jimeharrisjr/ESP8266_MotionDetection/Hardware/circuit.png

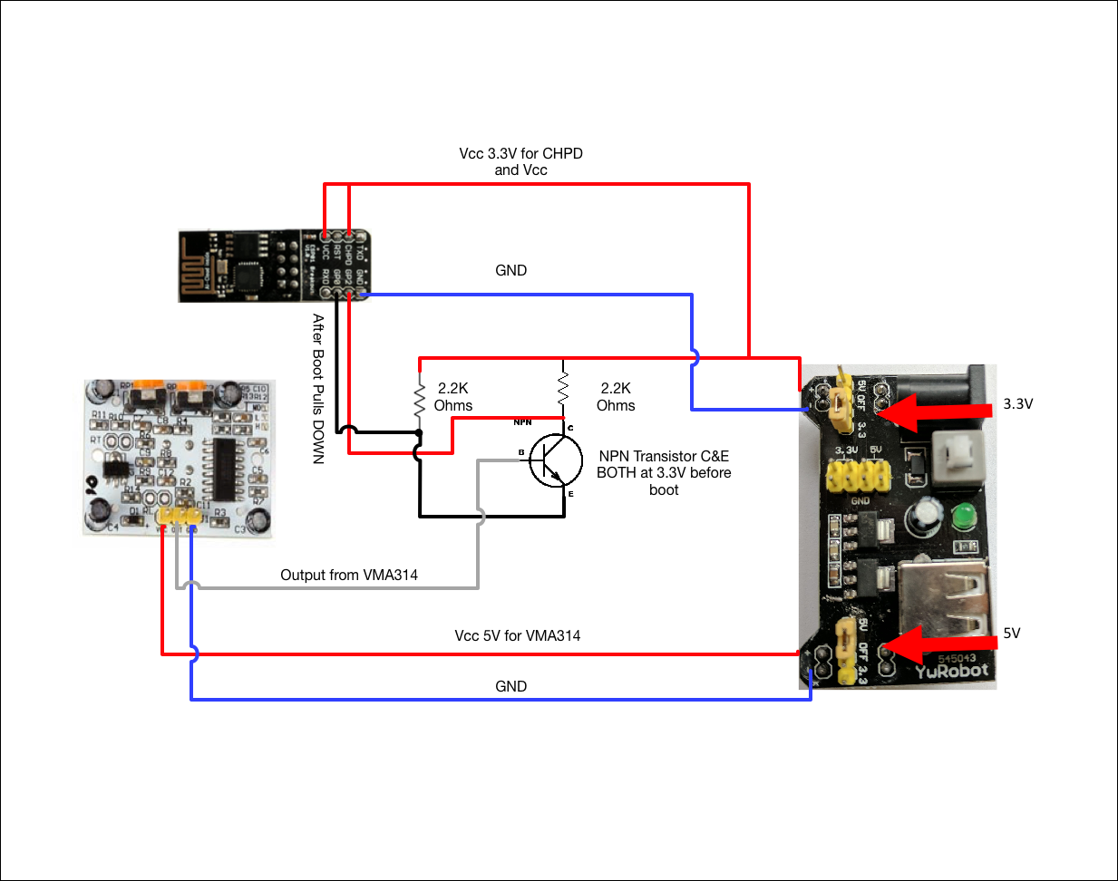
Hardware/circuit.png
